Alacrity-Education/AirBoxV2/(commit log)

2026-04-15 Start work on PCB
    [airbox.kicad_pcb, airbox.kicad_sch]
2026-04-22 Add dividers and make layout
    [airbox-CuBottom.gbr, airbox-CuTop.gbr, airbox-EdgeCuts.gbr, airbox-MaskBottom.gbr, airbox-MaskTop.gbr, airbox-NPTH.drl, airbox-PTH.drl, airbox-SilkBottom.gbr]
2026-04-23 Almost final version with aux temp sensor
    [airbox.kicad_pcb, airbox.kicad_sch]
2026-04-23 a bit of schematic cleanliness
2026-04-24 Final Version
    [airbox-CuBottom.gbr, airbox-CuTop.gbr, airbox-EdgeCuts.gbr, airbox-MaskBottom.gbr, airbox-MaskTop.gbr, airbox-NPTH.drl, airbox-PTH.drl, airbox-SilkBottom.gbr]
2026-05-11 Rework scematic
    [airbox.kicad_sch]
2026-06-19 Badge initial work
    [airbox-CuBottom.gbr, airbox-CuTop.gbr, airbox-EdgeCuts.gbr, airbox-MaskBottom.gbr, airbox-MaskTop.gbr, airbox-NPTH.drl, airbox-PTH.drl, airbox-SilkBottom.gbr]
2026-06-19 Badge finish
    [airbox.kicad_pcb]
2026-06-23 production version
    [airbox-CuBottom.gbr, airbox-CuTop.gbr, airbox-MaskBottom.gbr, airbox-MaskTop.gbr, airbox-NPTH.drl, airbox-PTH.drl, airbox-PasteBottom.gbr, airbox-PasteTop.gbr]
2026-07-16 Latest update with BOM changes
    [airbox.kicad_pcb]
2026-07-16 Add keepout for Caps and inductor
    [airbox.kicad_pcb]
2026-07-16 Added daughterboard display schematic
    [DAUGHTERBOARD_DIGITS.kicad_sch, airbox.kicad_sch]
2026-07-18 Addon modifications
    [DAUGHTERBOARD_DIGITS.kicad_sch, airbox.kicad_pcb, airbox.kicad_sch]
2026-07-19 Rework scematic for addon
    [DAUGHTERBOARD_DIGITS.kicad_sch, airbox.kicad_pcb]
2026-07-19 Finished addon with ground stitching
    [airbox.kicad_pcb, airbox.kicad_sch]
2026-07-19 Finish addon ecad
    [airbox.kicad_pcb]
2026-07-21 Middleware: slug URLs, live-source twins, deterministic sync, mock updates
    - Public dashboard slug layer: GET /public-dashboards/{slug} redirect
    controller; V6 adds artifacts.slug + backfill; V7 anglicizes view
    labels (map/station_overview/station_details); generated twin uids
    equal their slugs (abx-overview-<dev>, abx-details-<dev>).
    - All public twins now generated from the LIVE Grafana sources
    (fetch by uid + transformTwin): device variable executed away,
    owner_email stripped from public SQL, nav panels injected,
    hash-gated re-upserts. Jar dashboard templates deleted (only
    nav_panels.json remains); source uids configurable via
    MDW_GRAFANA_{OVERVIEW,STATION_OVERVIEW,STATION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
2026-07-21 Infrastructure: API dashboard provisioning, slug routing, landing page
    - Dashboards provisioned via Grafana API at first boot:
    scripts/provision-dashboards.py + provision-dashboards.yml
    (create-if-absent into pinned 'templates' folder, --force to
    overwrite, sets geomap as org home). Replaces file provisioning:
    provider.yaml, dashboards mount, infra JSON mirror and the drift
    guard are removed; API-created dashboards are unmanaged so UI
    edits are durable. Deploy order: create-config -> compose up ->
    provision-dashboards.
    - Old MQTT-stack remnants deleted (mock/, mosquitto/telegraf/
    prometheus templates); datasource template pinned to uid
    airbox-postgres (stays file-provisione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
2026-07-21 Docs: July 2026 deployment session changelog
    Chronological record of the V2 stack cutover and all subsequent
    changes (Grafana sync middleware, determinism hardening, slug URLs,
    translations, API provisioning, mock switches), plus the current
    deployment procedure and known follow-ups.
2026-07-21 Merge per-device overview and details into a single station dashboard
    - airbox-station-v2.json folded into airbox-station.json (uid kept,
    title "AirBox Station"): 13 exact-duplicate panels dropped, 11
    unique panels appended (history timeseries, extended station table,
    header, recommendations). Nav links across dashboards collapse to
    Map / Station / Overview.
    - One public twin per device: slug/uid stays abx-details-<dev> so
    distributed URLs survive; abx-overview-* twins retired. View value
    collapses to 'station' (V8 migration deletes station_overview rows
    and renames station_details).
    - Middleware: single MDW_GRAFANA_STATION_UID source property replaces
    the overview/details pa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
2026-07-21 Tab-style nav buttons on public dashboards + dashboard export helper
    - Replace the Navigation table with two native stat panels styled as
    tab buttons (active blue-gray #5a6b8c unlinked, inactive #2563eb
    one-click link). Backing query SELECT 1 (numeric — string frames
    render as No data on stat panels, killing both label and link).
    - Link URLs use the root-level form (no /g prefix): paths inside
    Grafana's appSubUrl get claimed by the SPA router, which parses the
    slug as a public accessToken ("Invalid access token"). Root-level
    paths escape the router; Caddy 302s them back into /g via the
    middleware. Verified with a headless-browser click test in both
    directions.
    - infrastruct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
2026-07-21 AQI enrichment at ingest, UI dashboard edits, retire SCD30 mock profile
    - AQI (EPA-style): per-reading sub-indices via truncation + linear
    interpolation over breakpoint tables (registry covers all six EPA
    pollutants; fed today by pm25/pm10 24h trailing means and nox as an
    NO2 1h-mean ppb proxy). Final AQI = max sub-index, rounded; NULL
    unless >=3 sub-indices incl. one PM. V9 adds nullable aqi +
    aqi_pollutant columns; enrichment runs in SensorReadingService
    before insert. 18 new tests (64 total).
    - Dashboards: exported UI edits — geomap Station map panel resized,
    overview stat titles renamed (Readings in interval, Avg PM2.5,
    Avg CO2); includes Grafana schemaVersion 42 save-m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
2026-07-21 Rename new-middleware/ to middleware/
    Directory rename plus every active reference: compose build contexts,
    provision/export script paths, ansible playbook comment, Maven
    artifactId/name (jar now middleware-*.jar, Dockerfile glob updated),
    spring.application.name. Java package com.cezar.newmiddleware left
    as-is (internal, out of scope). Historical docs keep the old name.
    Also captures a UI edit exported from Grafana: the overview
    "Devices reporting" panel query reworked in the editor.
2026-07-22 Docs: extend session changelog through the July 22 changes
    New sections: station-dashboard merge (V8), tab-button navigation and
    the SPA access-token gotcha, UI-edit export helper, AQI enrichment
    (V9), SCD30 retirement, module/package renames. Deployment-procedure
    notes updated (canonical dashboards dir, git/deploy-key hygiene) and
    every known-follow-up claim re-verified against the live system
    (stale export-helper item removed).
2026-07-23 Update latest version for the course
    [airbox.kicad_pcb]
2026-07-23 Interactive TUI script for registering AirBox installations
    infrastructure/scripts/register-airbox.py (stdlib-only): guided
    terminal wizard for inserting airbox_installations rows — field
    validation (device-id capped at 27 chars for the Grafana twin-uid
    limit), generated API key, uniqueness check, quote-safe inserts via
    psql variable binding over stdin (psql does not interpolate :'var'
    inside -c), and an optional middleware restart that waits for the
    sync and prints the station's public URL.
2026-07-24 Preinstall the Flow panel plugin (andrewbmchugh-flow-panel)
    Added to GRAFANA_PLUGINS alongside the Business Forms panel;
    installs at grafana boot via GF_INSTALL_PLUGINS.
2026-07-25 AQI: eligibility gate lowered to 2, CO2 sub-index, backfill script
    - Minimum computable sub-indices 3 -> 2 (>=1 PM still required) so
    real SEN66 devices (no raw NOx) qualify for AQI.
    - CO2 sub-index added: CUSTOM non-EPA breakpoint table derived from
    indoor-air guidance (0-600 ppm Good ... 5001-40000 Hazardous,
    clamp 500), 1h trailing mean, integer truncation.
    - infrastructure/scripts/backfill-aqi.py: recompute historical rows
    per device with identical semantics (trailing windows, truncation,
    breakpoints); temp-table COPY batch updates; --device/--all-null/
    --dry-run; drift warnings in both code sites. Cross-checked with 0
    mismatches against 18 middleware-enriched rows before t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
2026-07-27 Firmware: reason-driven cycle, SEN66 preheat nap, GPIO21 button, API rework
    The sketch now runs a small state machine branched on the sleep-reason code
    airboxBegin() returns (-1 = fresh boot), matching the course docs' flow
    diagram:
    - Fresh boot / REASON_DEEP_SLEEP: DS18B20 guard check (always-on rail);
    temps OK -> sensor rail on, SEN66 continuous measurement started, deep
    sleep 5 min (REASON_PREHEAT_SLEEP) with the rail held on so the gas
    signals settle (datasheet: VOC raw < 60 s, NOx raw < 300 s); temps bad ->
    sleep 15 min and retry.
    - REASON_PREHEAT_SLEEP: battery/solar measured before the radio boots
    (charging paused 2 s so the cell rests unloaded), WiFi associates in the
    ba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
    [airbox_net.h, config.h, firmware.ino, pins.h]
2026-07-27 Stateful VOC/NOx gas-index computation from raw SGP41 ticks
    Some SEN66 units send voc_raw/nox_raw ticks instead of the index
    values. The ingest now accepts them (0-65535, else 400), converts via
    the Sensirion GasIndexAlgorithm port (gasindex/ package, BSD header
    preserved), and stores the resulting voc_index/nox_index. Algorithm
    state is Jackson-serialized per (device_id, algo_type) into the new
    airbox_gas_algorithm table (V10); each ingest locks the row FOR
    UPDATE, processes with dt derived from updated_at, and upserts state
    in the same transaction as the reading insert. Explicitly sent index
    values win over raw and do not advance state. Mock gains a
    sen66_raw_ticks profile; ingest help pag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
2026-07-27 Firmware: drop BENCH_MODE and RUN_* switches - single standard run path
    - debug.h reduced to the logging macros; LOG_LEVEL fixed at LOG_INFO
    - runCycle() unconditional: no per-stage RUN_* gates, no offline variant
    - airboxSleep() always deep-sleeps (bench pretend-sleep removed),
    airboxUpload() always POSTs, no-credentials setup-mode check ungated
    - Boot wait-for-serial-host removed along with DEBUG_WAIT_SERIAL
    - Kept: LOG_LEVEL machinery, INGEST_ROOT_CA and ping_sock config/platform
    conditionals
    - Docs scrubbed of bench/RUN_* mentions
    [airbox_net.h, config.h, debug.h, firmware.ino]
2026-07-27 Firmware: upload raw SGP41 ticks instead of on-device gas indices
    readSen66() additionally calls readMeasuredRawValues() and the payload
    now carries voc_raw/nox_raw (0..65534); voc_index/nox_index are no
    longer sent - an explicitly sent index would override the ingest's
    stateful raw processing and stall its per-device algorithm state. The
    0xFFFF "unknown" sentinel is filtered out firmware-side because the
    server would accept 65535 as a genuine tick. The 5-min preheat still
    conditions the raw signals (SRAW_NOx < 300 s per datasheet 1.4).
    [firmware.ino]
2026-07-28 Geomap: lowercase geohash at query time
    Firmware sends mixed-case geohashes; geohash decoding expects
    lowercase base32, so the map query normalizes with lower() —
    decode-side only, stored values untouched.
2026-08-23 Add NRF footprint
2026-08-23 Remove unused docs
    [airbox-CuBottom.gbr, airbox-CuTop.gbr, airbox-EdgeCuts.gbr, airbox-MaskBottom.gbr, airbox-MaskTop.gbr, airbox-NPTH.drl, airbox-PTH.drl, airbox-PasteBottom.gbr]
2026-09-03 added assembled unit photo
2026-09-03 resized assembled airbox photo
2026-09-03 fixed track record
2026-09-12 firmware fixes + sleep time reduction + voc/nox removal
    [airbox_net.h, config.h, firmware.ino]
