Alacrity-Education/AirBoxV2/badge/airbox.kicad_pcb

## KiCad design badge/airbox.kicad_pcb (2026-06-19)

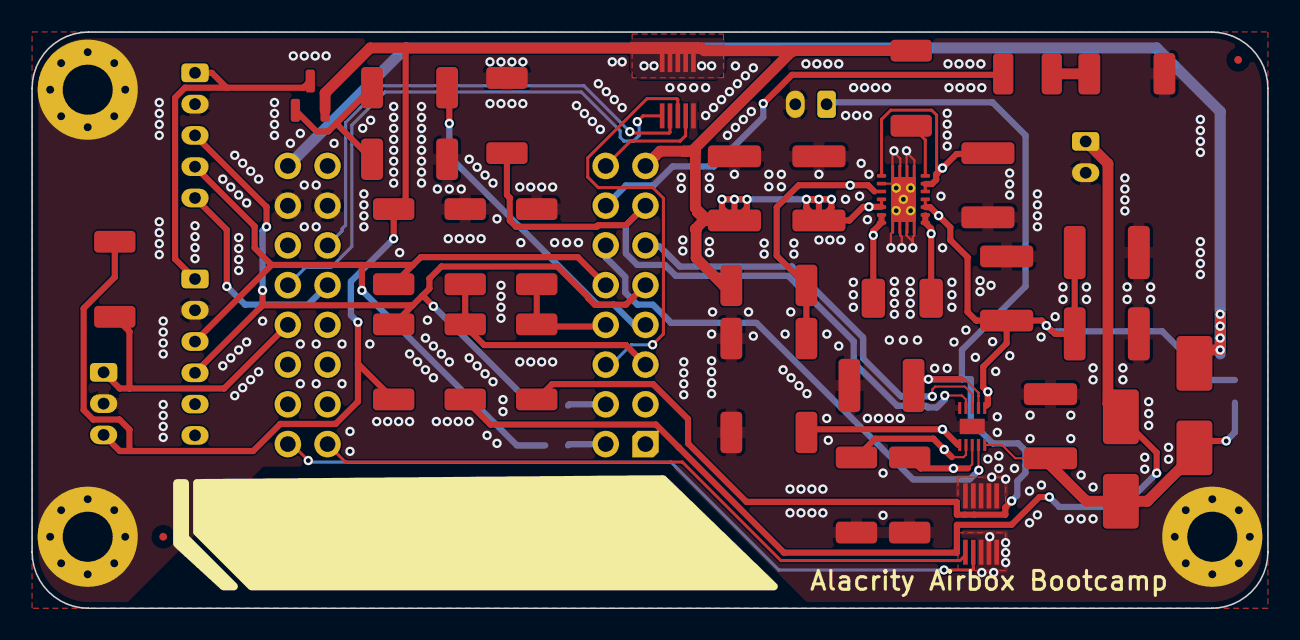
[picture p1: board airbox.kicad_pcb from above]

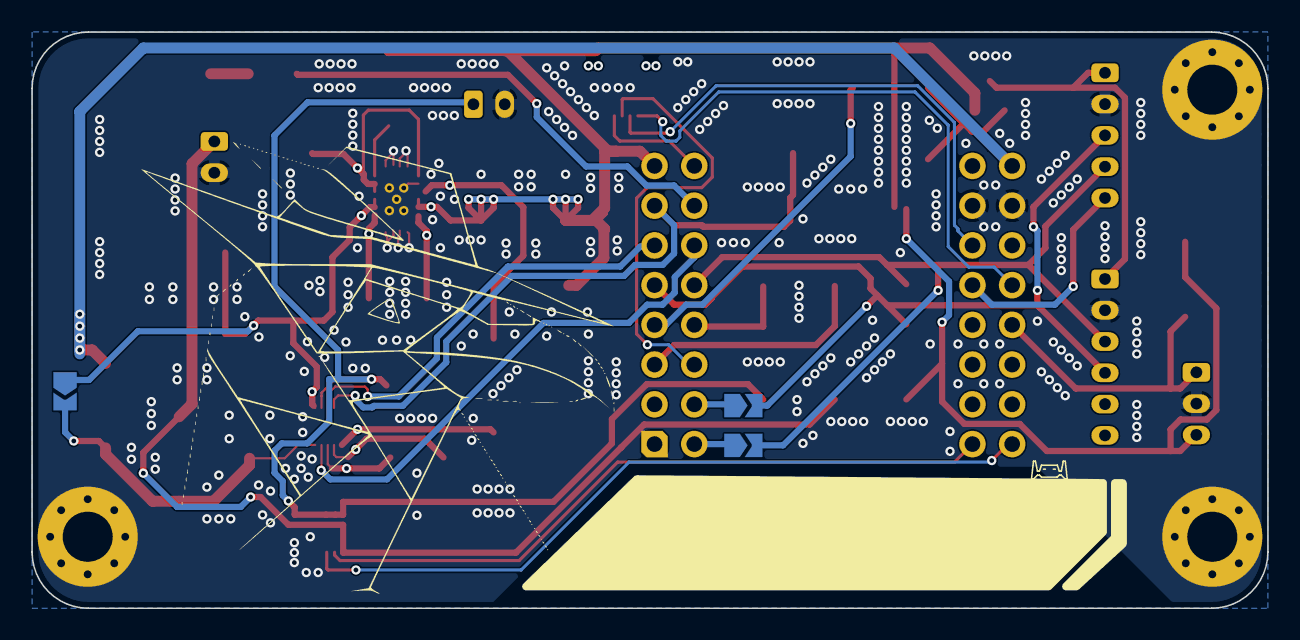
[picture p2: board airbox.kicad_pcb from below]

Board: 2 copper layers, 79.0 x 36.8 mm, 48 parts (3 on the bottom side), 37 nets.

Parts:
C3, C7: 22u; C_1812_4532Metric
C4: 100n; C_1812_4532Metric
C5, C6, C10: 10u; C_1812_4532Metric
C8, C9: 1u; C_1812_4532Metric
D1, D2: SS24 SMB; D_SMB_Handsoldering
D3: LED; R_1210_3225Metric_Pad1.30x2.65mm_HandSolder
H1, H2, H3: MountingHole_Pad; MountingHole_3.2mm_M3_Pad_Via
J1: SEN66; JST_PH_B6B-PH-K_1x06_P2.00mm_Vertical
J2: MCU-CONN-1; Fiducial_0.5mm_Mask1.5mm
J3: SOLAR; JST_PH_B2B-PH-K_1x02_P2.00mm_Vertical
J4: BATTERY; JST_PH_B2B-PH-K_1x02_P2.00mm_Vertical
J5: SCD30; JST_PH_B5B-PH-K_1x05_P2.00mm_Vertical
J6: MCU-CONN-2; Fiducial_0.5mm_Mask1.5mm
J7: Conn_01x03; JST_PH_B3B-PH-K_1x03_P2.00mm_Vertical
J9, J10: MEZ_SIGNALS; Hirose_DF12_DF12E3.0-10DP-0.5V_2x05_P0.50mm_Vertical
JP1: SDA-GPIO1; SolderJumper-2_P1.3mm_Open_TrianglePad1.0x1.5mm
JP2: SCL-GPIO2; SolderJumper-2_P1.3mm_Open_TrianglePad1.0x1.5mm
JP3: BYPASS-DNP; SolderJumper-2_P1.3mm_Open_TrianglePad1.0x1.5mm
L1: 1.5u; L_APV_APH0412
Q1: AO3401A; SOT-23
R5, R6: 1M; R_2010_5025Metric_Pad1.40x2.65mm_HandSolder
R7: 180k; R_2010_5025Metric_Pad1.40x2.65mm_HandSolder
R8, R12, R14, R15, R20: 10k; R_2010_5025Metric_Pad1.40x2.65mm_HandSolder
R9: 2k; R_2010_5025Metric_Pad1.40x2.65mm_HandSolder
R10: 13k; R_2010_5025Metric_Pad1.40x2.65mm_HandSolder
R11, R13: 100; R_2010_5025Metric_Pad1.40x2.65mm_HandSolder
R16, R17, R19: 100K; R_2010_5025Metric_Pad1.40x2.65mm_HandSolder
R18: 330K; R_2010_5025Metric_Pad1.40x2.65mm_HandSolder
R21: 4.7k; R_2010_5025Metric_Pad1.40x2.65mm_HandSolder
U1: WeMos_S2_mini; ESP32-S2-Mini
U2: BQ25185DLHR; WSON10_DLH_TEX-M
U3: TPS63020DSJ; Texas_R-PVSON-N14_ThermalVias

Connections:
+3V3: C3.1, C7.1, J7.3, J9.6, J9.7, J9.8, J9.9, J9.10, Q1.2 (S), R5.2, R6.2, R14.1, R15.1, R21.2, U1.8 (3V3), U3.4 (VOUT), U3.5 (VOUT)
/3V3-SENSOR: J1.1, J5.1, Q1.3 (D)
/SYSREG: C5.1, C6.1, C10.2, JP3.1 (A), U2.1 (SYS), U3.10 (VIN), U3.11 (VIN)
CHR-DISABLE: R20.1, U1.7 (GPIO12), U2.4 (/CE)
CHR-STAT1: U1.22 (GPIO10), U2.9 (STAT1)
CHR-STAT2: U1.6 (GPIO11), U2.3 (STAT2)
DS18B20-DATA: J7.1, R21.1, U1.13 (GPIO33)
GND: C3.2, C4.1, C5.2, C6.2, C7.2, C8.2, C9.1, C10.1, H1.1 (1_1), H2.1 (1_1), H3.1 (1_1), J1.2, J3.2, J4.2, J5.2, J7.2, J9.5, J10.3, J10.4, J10.5, J10.6, J10.7, J10.8, J10.9, J10.10, R7.2, R8.1, R9.1, R10.1, R11.1, R12.2, R17.2, R19.2, R20.2, U1.10 (GND), U1.26 (GND), U2.5 (GND), U2.11 (EPAD), U3.2 (GND), U3.15 (PGND)
GPIO4: J9.3, U1.19 (GPIO4)
GPIO14: J9.4, U1.24 (GPIO14)
GPIO17: J9.2, U1.27 (DAC_1)
GPIO18: J9.1, U1.12 (DAC_2)
GPIO39: J10.2, U1.16 (GPIO39)
GPIO40: J10.1, U1.32 (GPIO40)
LED: D3.2 (A), U1.23 (GPIO13)
unnamed: C8.1, D1.1 (K), D2.1 (K), JP3.2 (B), U2.10 (IN)
unnamed: D3.1 (K), R11.2
unnamed: JP1.1 (A), U1.17 (GPIO1)
unnamed: JP2.1 (A), U1.18 (GPIO2)
unnamed: L1.1, U3.8 (L1), U3.9 (L1)
unnamed: L1.2, U3.6 (L2), U3.7 (L2)
unnamed: Q1.1 (G), R12.1, R13.1
unnamed: R10.2, U2.7 (ILIM/VSET)
unnamed: R9.2, U2.8 (ISET)
unnamed: R8.2, U2.6 (TS/MR)
unnamed: C4.2, U3.1 (VINA), U3.12 (EN), U3.13 (~PS/SYNC)
unnamed: R6.1, R7.1, U3.3 (FB)
unnamed: R5.1, U3.14 (PG)
SCD30RDY: J5.5, U1.28 (GPIO21)
SCL: J1.4, J5.3, JP2.2 (B), R15.2, U1.5 (GPIO9)
SDA: J1.3, J5.4, JP1.2 (B), R14.2, U1.21 (GPIO8)
SENSE-BAT: R16.2, R17.1, U1.20 (GPIO6)
SENSE-SOLAR: R18.2, R19.1, U1.3 (GPIO5)
SENSOR-POWER: R13.2, U1.4 (GPIO7)
VBAT: C9.2, J4.1, R16.1, U2.2 (BAT)
VBUS: D2.2 (A), U1.9 (VBUS)
VSOLAR: D1.2 (A), J3.1, R18.1
